sorchowski/AVC2018/doc/images/robo_guts.jpg

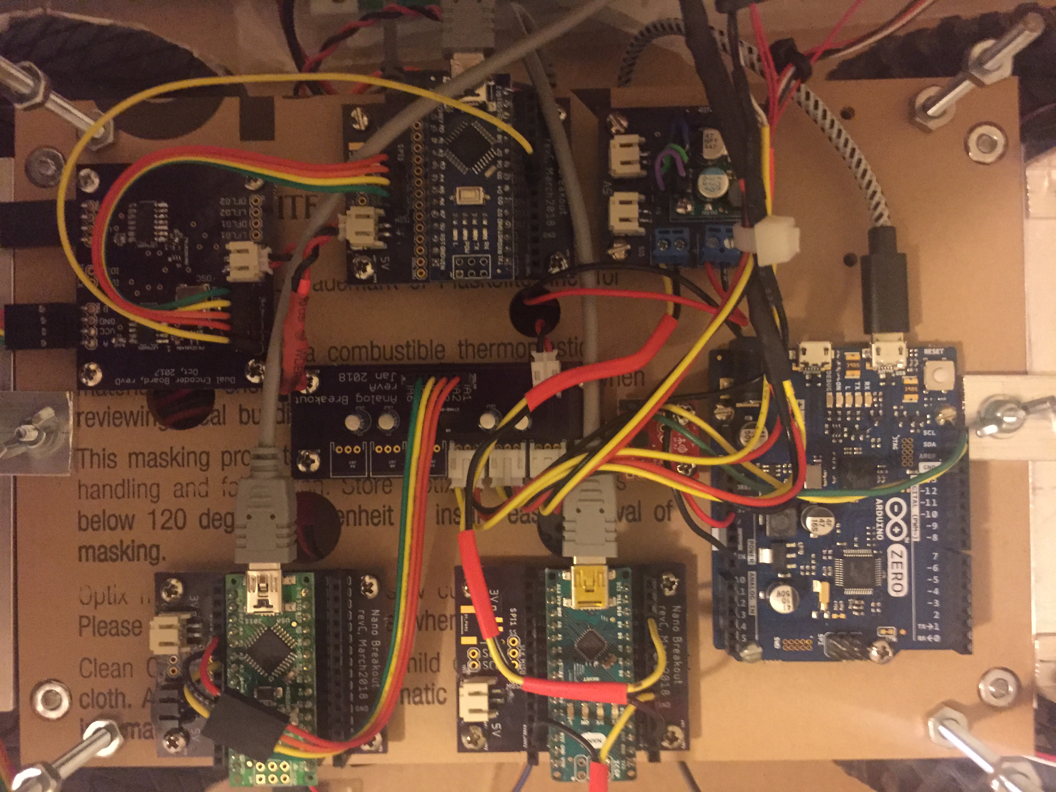
doc/images/robo_guts.jpg
