sorchowski/AVC2018/doc/images/sonar_prototype2.JPG

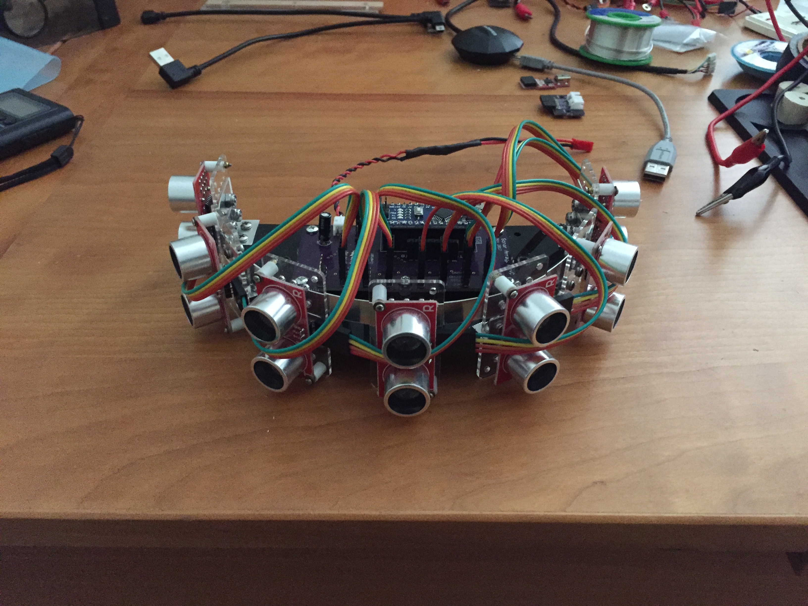
doc/images/sonar_prototype2.JPG
