sorchowski/AVC2018/doc/images/prototype1.jpg

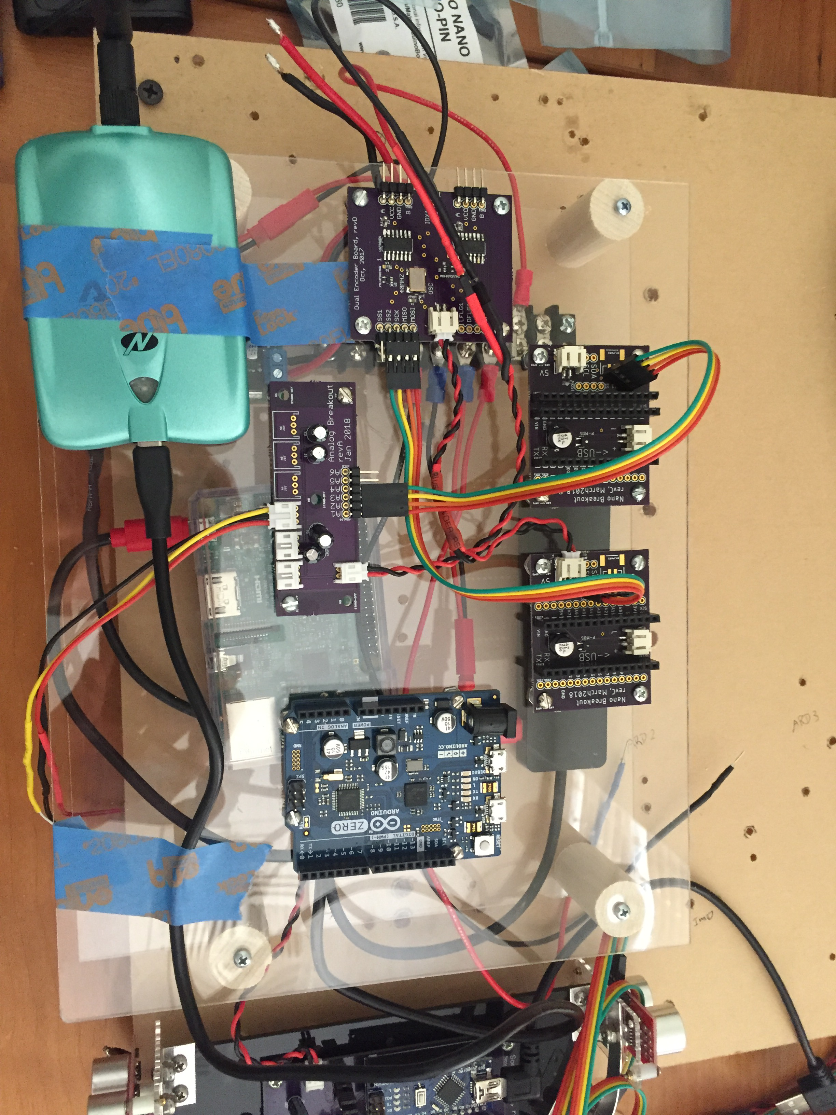
doc/images/prototype1.jpg
