sorchowski/AVC2018/doc/images/prototype2.jpg

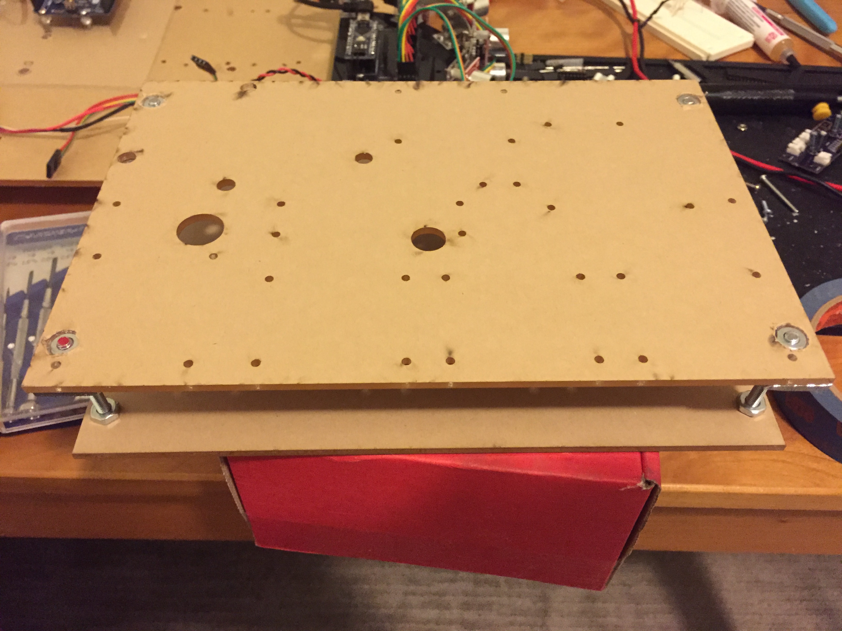
doc/images/prototype2.jpg
