sorchowski/AVC2018/doc/images/prototype3.jpg

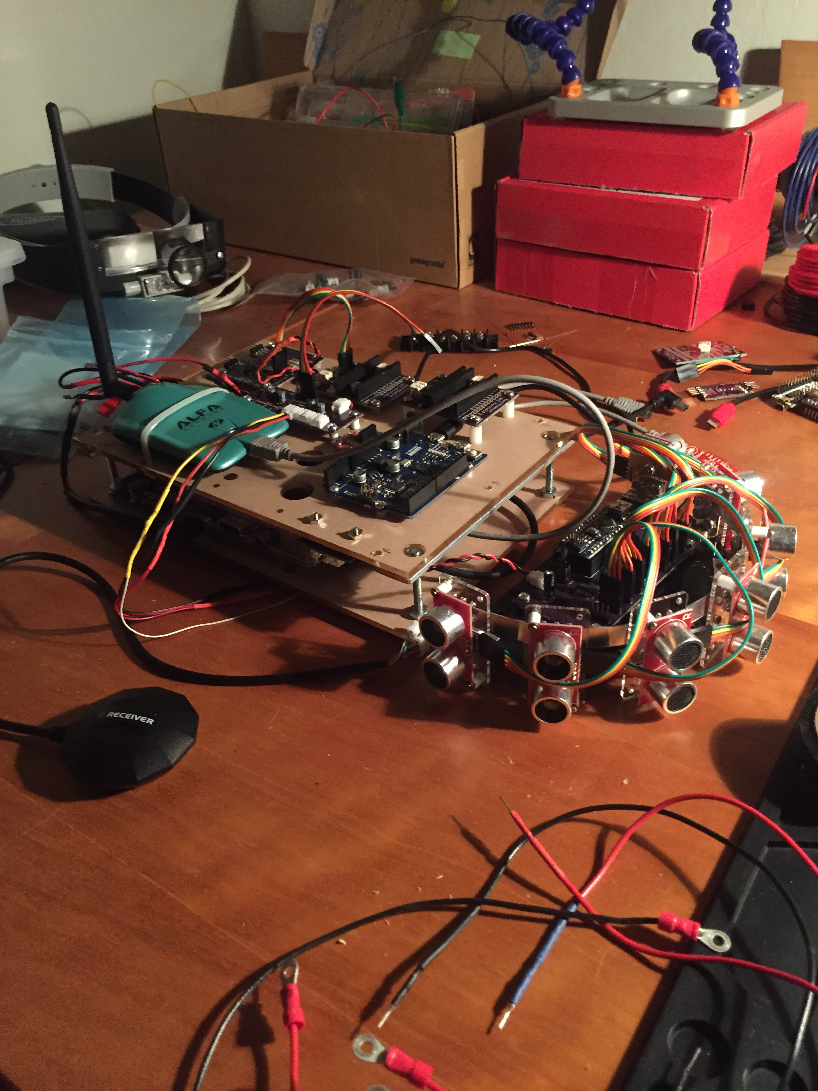
doc/images/prototype3.jpg
