sorchowski/AVC2018/doc/images/prototype4.jpg

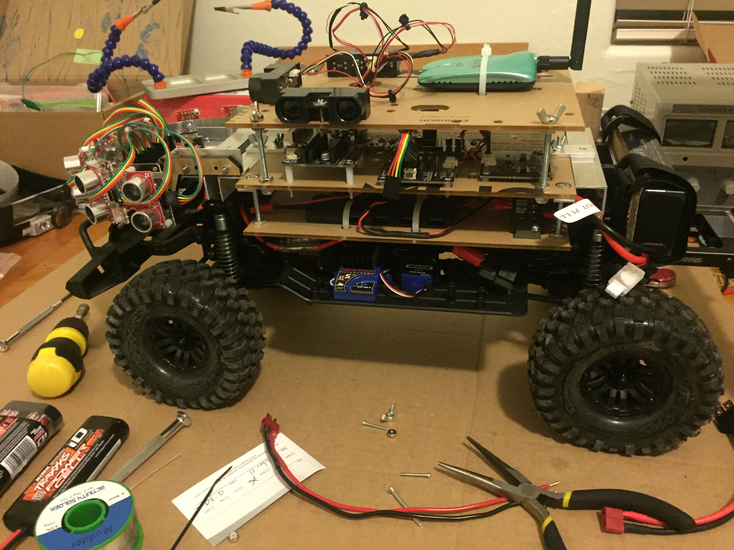
doc/images/prototype4.jpg
