sorchowski/AVC2018/doc/images/roadtrip.jpg

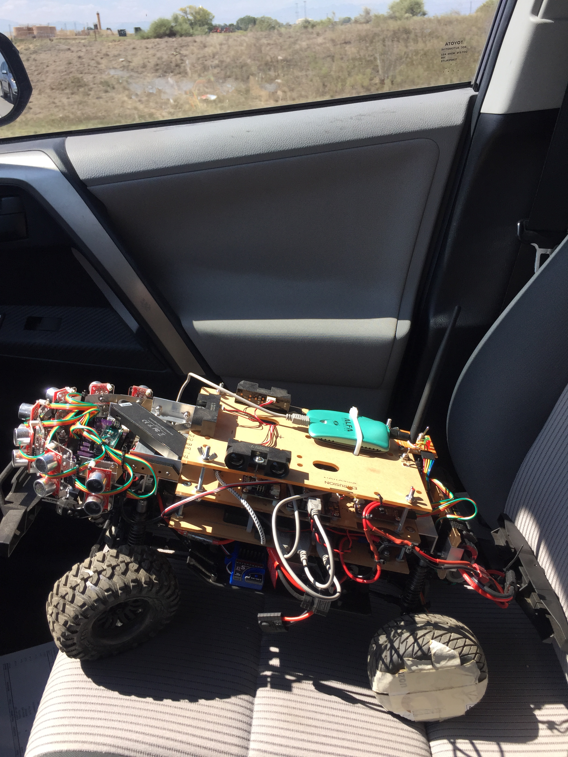
doc/images/roadtrip.jpg
