sorchowski/AVC2018/doc/images/sonar_prototype.jpg

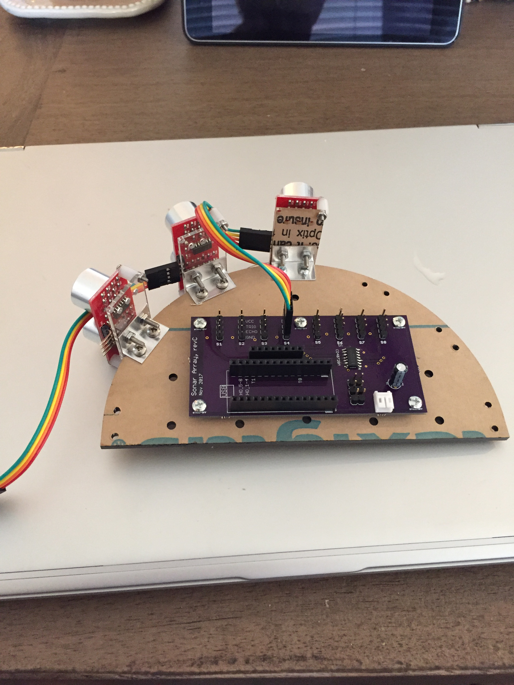
doc/images/sonar_prototype.jpg
