sorchowski/AVC2018/doc/images/trx4.jpg

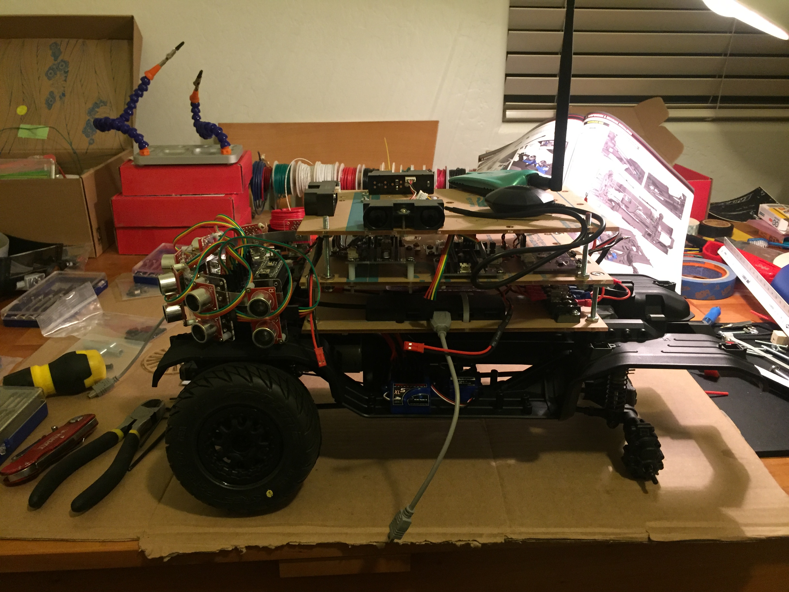
doc/images/trx4.jpg
