sorchowski/AVC2018/doc/images/watbot.jpg

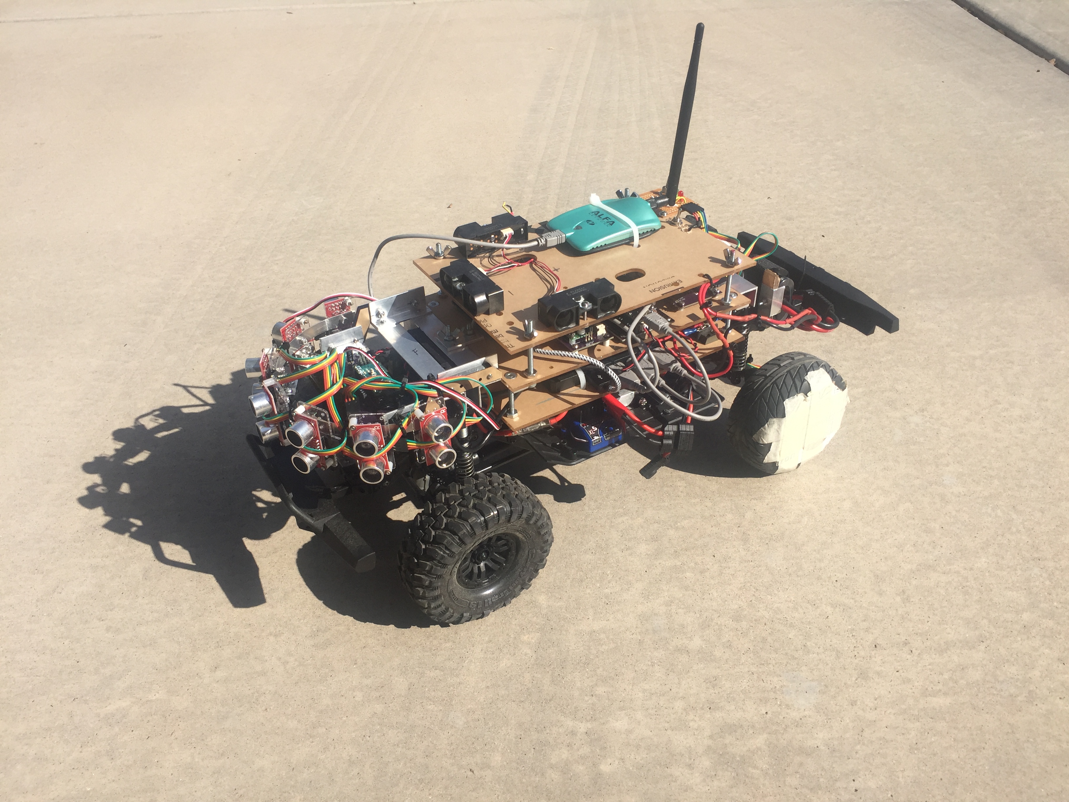
doc/images/watbot.jpg
