sorchowski/AVC2018/doc/ros_setup/ros_windows_setup.txt

From https://janbernloehr.de/2017/06/10/ros-windows

	sudo sh -c 'echo "deb http://packages.ros.org/ros/ubuntu $(lsb_release -sc) main" > /etc/apt/sources.list.d/ros-latest.list'
	sudo apt-key adv --keyserver hkp://ha.pool.sks-keyservers.net:80 --recv-key 421C365BD9FF1F717815A3895523BAEEB01FA116
	sudo apt-get update
	sudo apt-get install -y ros-kinetic-desktop-full
	sudo rosdep init
	rosdep update

	echo "source /opt/ros/kinetic/setup.bash" >> ~/.bashrc
	source ~/.bashrc

http://wiki.ros.org/rosserial_arduino/Tutorials/Arduino%20IDE%20Setup

	sudo apt-get install ros-kinetic-rosserial-arduino
	sudo apt-get install ros-kinetic-rosserial

	mkdir -p ~/catkinws/src
	cd ~/catkinws/src
	git clone https://github.com/ros-drivers/rosserial.git
	cd ~/catkinws
	catkin_make

	mkdir ~/ard_libs
	cd ~/ard_libs
	rosrun rosserial_arduino make_libraries.py .

	# Then copy over the contents of the "ard_libs" directory to the arduino libraries directory
