sorchowski/AVC2018/doc/images/cpu_usage_watbot.jpg

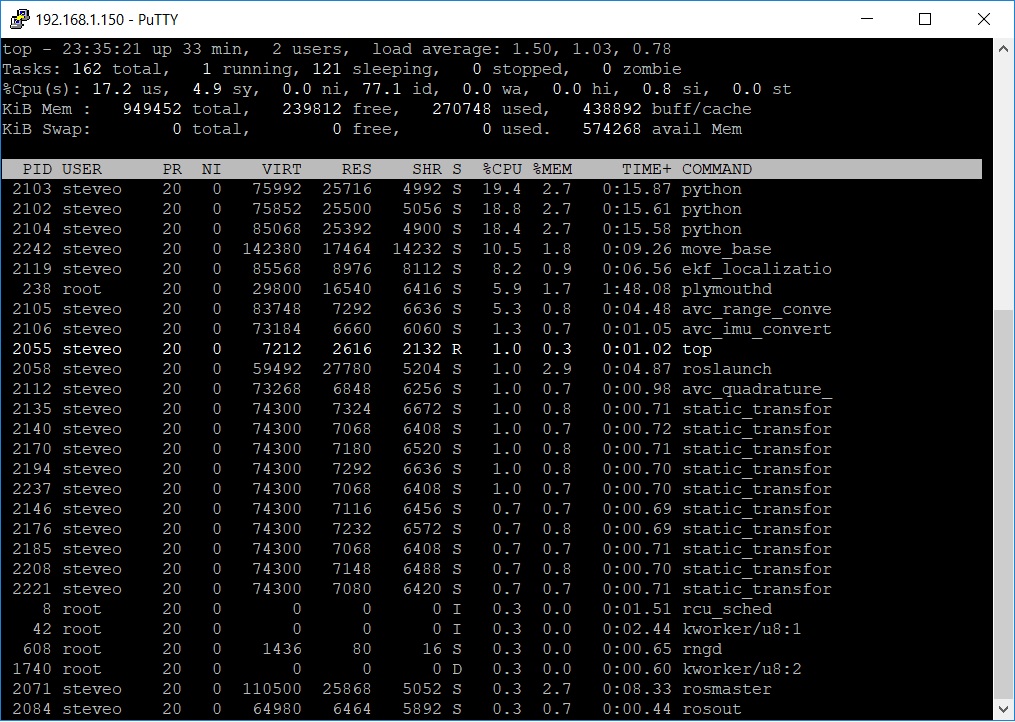
doc/images/cpu_usage_watbot.jpg
