sorchowski/AVC2018/src/evaluate/gps/README.md

Sample code to test the GPS "mouse" sourced from Sparkfun

https://www.sparkfun.com/products/14198?_ga=2.83605663.80319983.1517452477-876366777.1517208568

Hookup Guide - https://learn.sparkfun.com/tutorials/gps-mouse---gp-808g-hookup-guide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
