sorchowski/AVC2018/(commit log)

2018-02-03 add ArduinoLibs submodule
2018-02-03 update arduinoLibs commit
2018-02-03 add script for updating arduino ide libraries
2018-02-17 Update arduino libs, fix ros_lib reference, and add imu sketch
    [imu.ino]
2018-02-17 Update imu and gps node files
2018-02-19 Setup some of the initial arduino modules
2018-02-20 Update arduinolibs and libnmea library references
2018-06-24 Add servo test sketch
2018-07-19 more changes for imu and odometry
2018-07-23 update ArduinoLibs to latest
2018-07-26 lots of minor changes following arduino node testing
2018-07-28 Restructure imu node
2018-07-28 minor fix for imu node
2018-07-31 Fix incorrect ss for velocity 2
    [quadrature.ino]
2018-07-31 arduino modules adjustments
2018-07-31 Minor imu converter fix
2018-08-03 Update topics for imu and quadrature
2018-08-05 set default covariance values for imu data
2018-08-13 Add covariance values to imu
2018-08-13 Add mapping for velocity commands to servo values
2018-08-13 Adjust sample rates for imu and range nodes
2018-08-14 Add imu output data for covariance calculation
2018-08-17 update imu and range converter nodes
2018-08-21 add new version of sonar sketch
2018-08-25 add initial button read and status indicator to navigation trigger
2018-08-29 Update ArduinoLibs
2018-08-29 steering improvements
2018-08-29 Add driver node, simple goals modifications
2018-09-02 update velocity calculation model
2018-09-02 velocity and launch fixes
    [quadrature.ino, test_velocity.cpp]
2018-09-03 Fix simple goal frame, update teb local planner parameters
    [simple_navigation_goals.cpp]
