sorchowski/AVC2018/doc/images/linedup.jpg

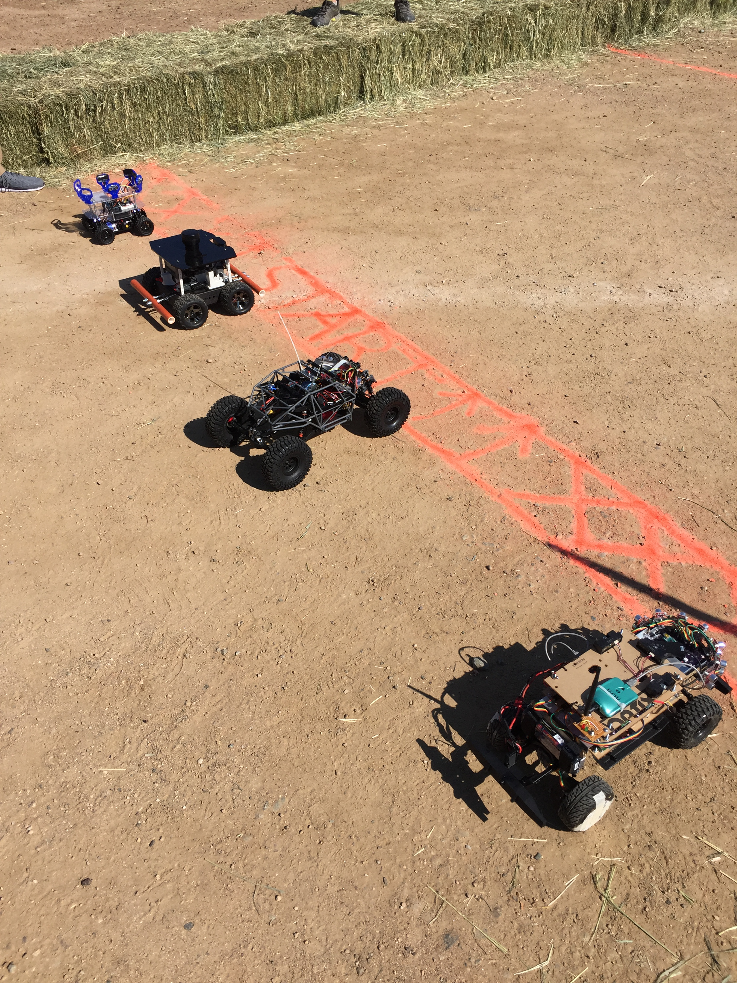
doc/images/linedup.jpg
